softmasterge/hardware_a1/SS34B-HF/3D/SS34B-HF.stp

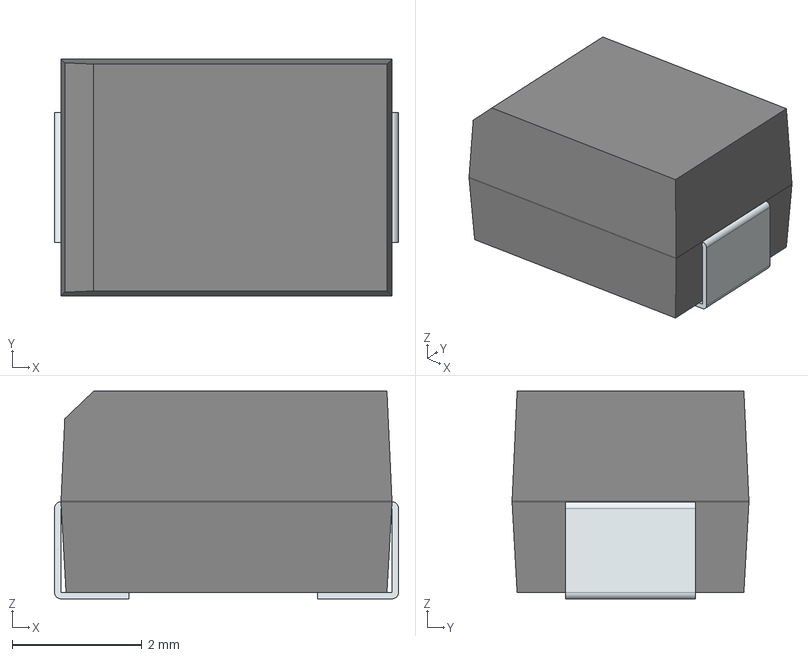
[picture p1: CAD file, 2021-02-08]
SS34B-HF/3D/SS34B-HF.stp
5.30 x 3.65 x 3.20 mm
FilletPin1
FilletPin2
