softmasterge/hardware_a1/supercap/XH414HG-IV01E.step

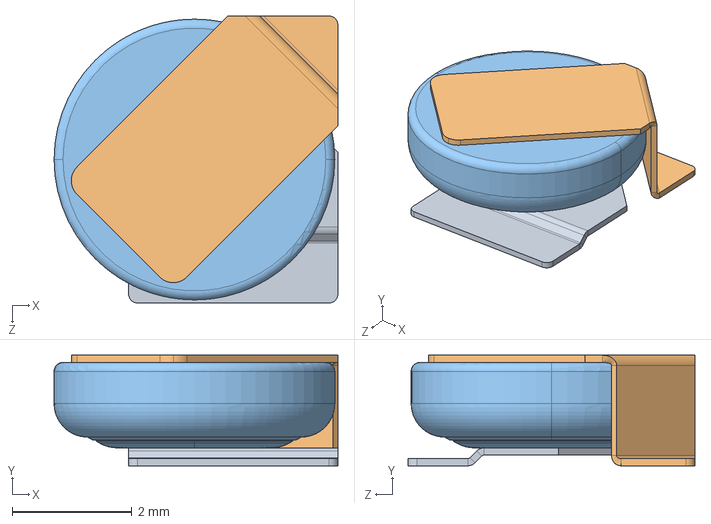
[picture p2: CAD file, 2021-02-16]
supercap/XH414HG-IV01E.step
4.75 x 1.85 x 4.80 mm
