softmasterge/hardware_a1/(list of files, cad)

Other CAD files:
SS34B-HF/3D/SS34B-HF.stl
SS34B-HF/Allegro/diom5336x320n.psm
SS34B-HF/DEHDL/ss34b_hf/chips/chips.prt
