softmasterge/hardware_a1/small/saxli.kicad_pcb

## KiCad design small/saxli.kicad_pcb (2021-03-10)

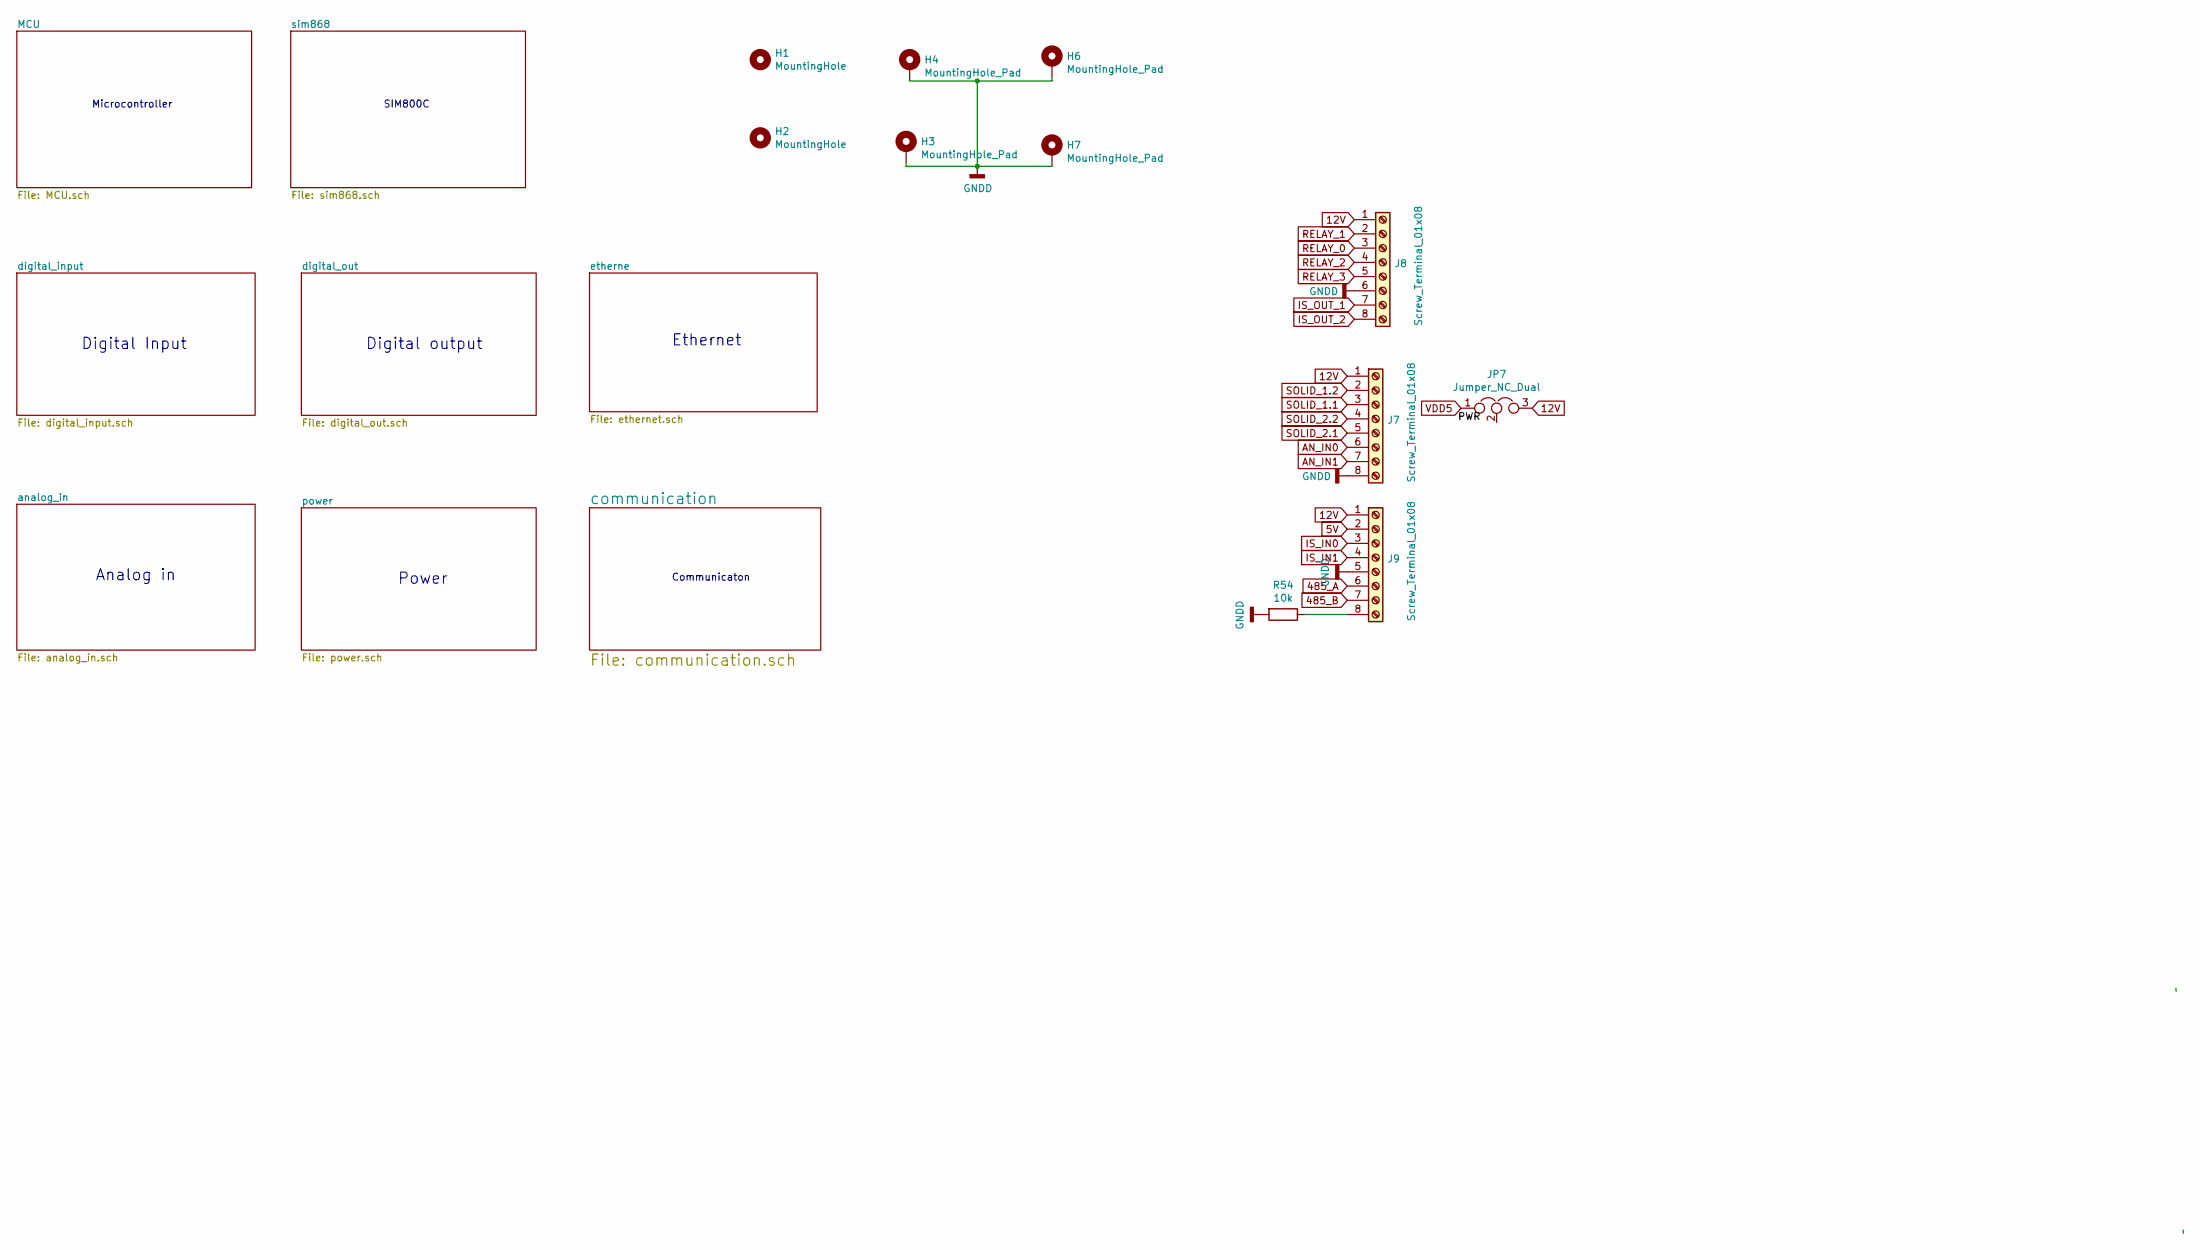
[picture p3: schematic saxli.sch]

Parts:
H1, H2: MountingHole; MountingHole_3.2mm_M3; LCSC N/A
H3, H4, H6, H7: MountingHole_Pad; MountingHole_3.2mm_M3_Pad; Mpn #; LCSC N/A
J7, J8, J9: Screw_Terminal_01x08; TerminalBlock_Phoenix_MPT-0,5-8-2.54_1x08_P2.54mm_Horizontal; LCSC N/A
JP7: Jumper_NC_Dual; SolderJumper-3_P1.3mm_Open_Pad1.0x1.5mm; LCSC N/A
R54: 10k; R_0603_1608Metric; MPN 0603WAF1002T5E; LCSC C25804

Connections:
5V: J9.2
12V: J7.1, J8.1, J9.1, JP7.3; also elsewhere on the board
485_A: J9.6; also elsewhere on the board
485_B: J9.7; also elsewhere on the board
AN_IN0: J7.6; also elsewhere on the board
AN_IN1: J7.7; also elsewhere on the board
GND: H3.1, H4.1, H6.1, H7.1, J7.8, J8.6, J9.5, R54.2; also elsewhere on the board
IS_IN0: J9.3; also elsewhere on the board
IS_IN1: J9.4; also elsewhere on the board
IS_OUT_1: J8.7; also elsewhere on the board
IS_OUT_2: J8.8; also elsewhere on the board
unnamed: J9.8, R54.1
RELAY_0: J8.3; also elsewhere on the board
RELAY_1: J8.2; also elsewhere on the board
RELAY_2: J8.4; also elsewhere on the board
RELAY_3: J8.5; also elsewhere on the board
SOLID_1.1: J7.3; also elsewhere on the board
SOLID_1.2: J7.2; also elsewhere on the board
SOLID_2.1: J7.5; also elsewhere on the board
SOLID_2.2: J7.4; also elsewhere on the board
VDD5: JP7.1; also elsewhere on the board

Notes on the sheet:
Microcontroller
Digital Input
Digital output
Ethernet
Analog in
Power
Communicaton
SIM800C

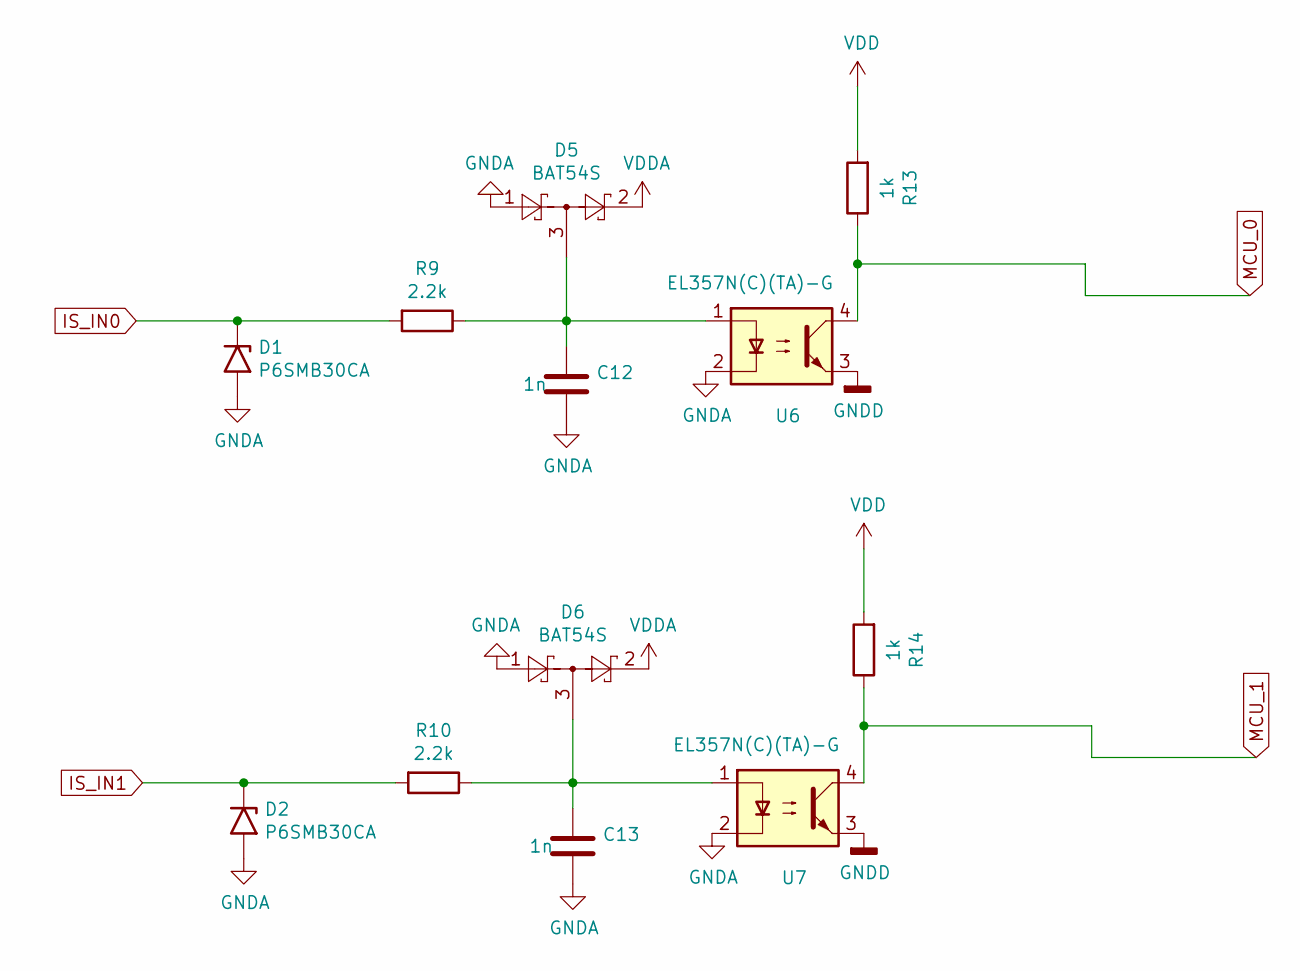
[picture p4: schematic digital_input.sch]

Parts:
C12, C13: 1n; C_0603_1608Metric; MPN CL21B102KBCNNNC; LCSC C46653
D1, D2: P6SMB30CA; D_SMB; MPN P6SMB30CA; LCSC C320521
D5, D6: BAT54S; SOT-23; MPN BAT54S L44; LCSC C122856
R9, R10: 2.2k; R_0805_2012Metric; MPN 0805W8F2201T5E; LCSC C17520
R13, R14: 1k; R_0805_2012Metric; MPN 0805W8F1001T5E; LCSC C17513
U6, U7: EL357N(C)(TA)-G; SO-4_4.4x3.6mm_P2.54mm; MPN EL357N(C)(TA)-G; LCSC C29981

Connections:
GND: C12.2, C13.2, D1.2 (A2), D2.2 (A2), D5.1, D6.1, U6.2, U6.3, U7.2, U7.3; also elsewhere on the board
IS_IN0: D1.1 (A1), R9.2; also elsewhere on the board
IS_IN1: D2.1 (A1), R10.2; also elsewhere on the board
MCU_0: R13.1, U6.4; also elsewhere on the board
MCU_1: R14.1, U7.4; also elsewhere on the board
unnamed: C12.1, D5.3, R9.1, U6.1
unnamed: C13.1, D6.3, R10.1, U7.1
VDD3: R13.2, R14.2; also elsewhere on the board
VDDA: D5.2, D6.2; also elsewhere on the board

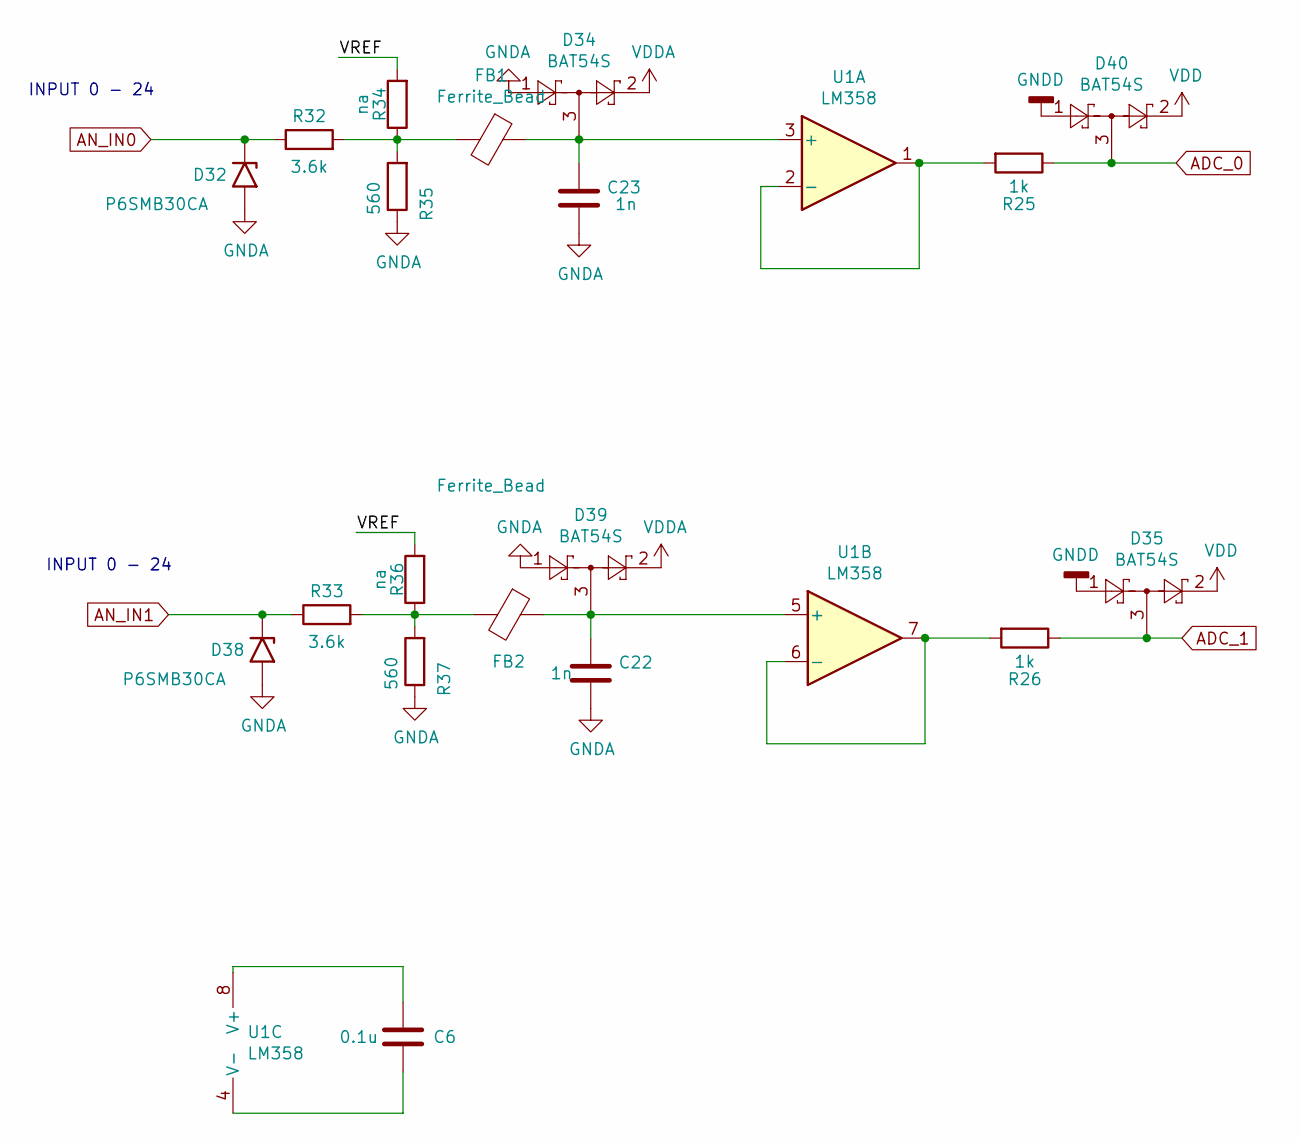
[picture p5: schematic analog_in.sch]

Parts:
C6: 0.1u; C_0603_1608Metric; MPN CC0603KRX7R9BB104; LCSC C14663
C22, C23: 1n; C_0603_1608Metric; MPN CL21B102KBCNNNC; LCSC C46653
D32, D38: P6SMB30CA; D_SMB; MPN P6SMB30CA; LCSC C320521
D34, D35, D39, D40: BAT54S; SOT-23; MPN BAT54S L44; LCSC C122856
FB1, FB2: Ferrite_Bead; R_0805_2012Metric_Pad1.20x1.40mm_HandSolder; MPN GZ2012D601TF; LCSC C1017
R25, R26: 1k; R_0603_1608Metric; MPN 0603WAF1001T5E; LCSC C21190
R32, R33: 3.6k; R_0805_2012Metric; MPN 0805W8F3601T5E; LCSC C18359
R34, R36: na; R_0603_1608Metric; LCSC N/A
R35, R37: 560; R_0805_2012Metric; MPN 0805W8F5600T5E; LCSC C28636
U1: LM358; SOIC-8_3.9x4.9mm_P1.27mm; LCSC C7950

Connections:
/analog_in/VREF: R34.2, R36.2
ADC_0: D40.3, R25.1; also elsewhere on the board
ADC_1: D35.3, R26.1; also elsewhere on the board
AN_IN0: D32.1 (A1), R32.1; also elsewhere on the board
AN_IN1: D38.1 (A1), R33.1; also elsewhere on the board
GND: C22.2, C23.2, D32.2 (A2), D34.1, D35.1, D38.2 (A2), D39.1, D40.1, R35.1, R37.1; also elsewhere on the board
unnamed: C6.1, U1.8 (V+)
unnamed: C6.2, U1.4 (V-)
unnamed: C22.1, D39.3, FB2.1, U1.5 (+)
unnamed: C23.1, D34.3, FB1.1, U1.3 (+)
unnamed: FB1.2, R32.2, R34.1, R35.2
unnamed: FB2.2, R33.2, R36.1, R37.2
unnamed: R25.2, U1.1, U1.2 (-)
unnamed: R26.2, U1.6 (-), U1.7
VDD3: D35.2, D40.2; also elsewhere on the board
VDDA: D34.2, D39.2; also elsewhere on the board

Notes on the sheet:
INPUT 0 - 24

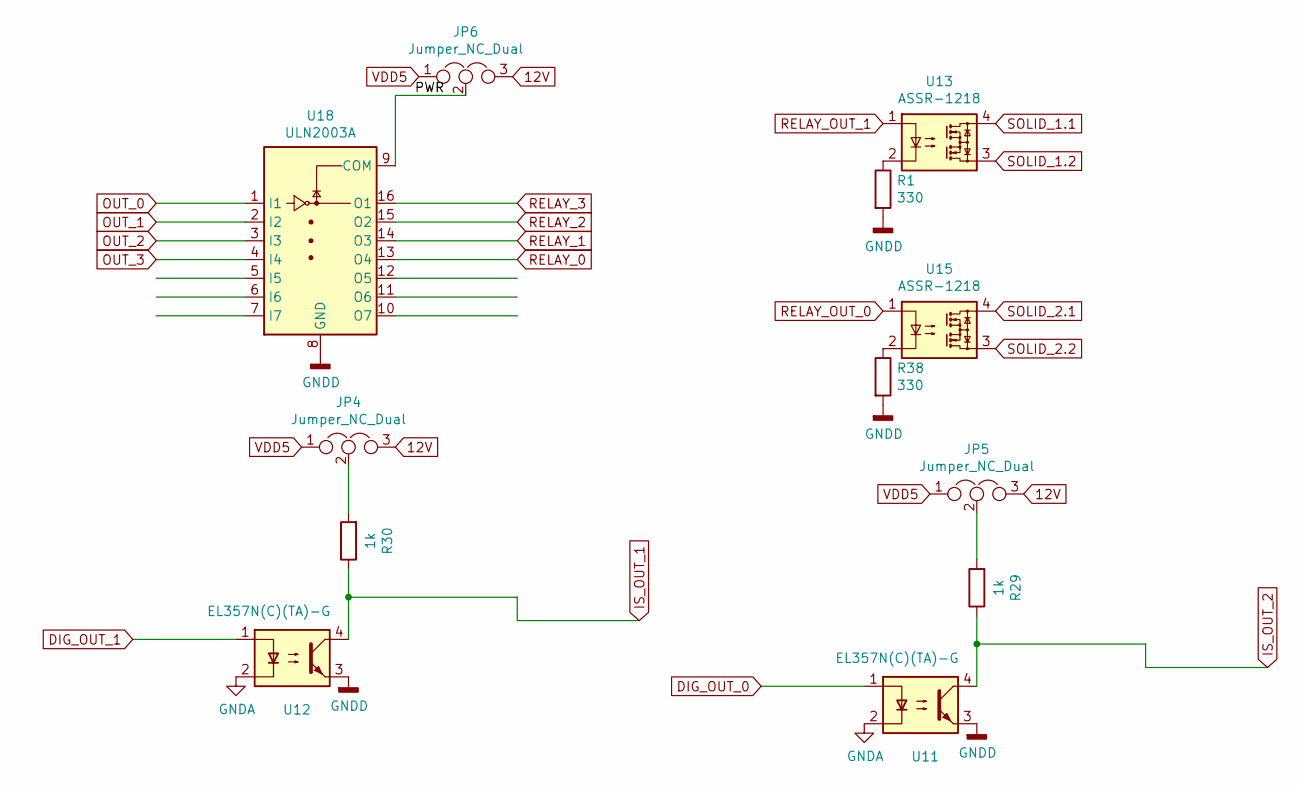
[picture p6: schematic digital_out.sch]

Parts:
JP4, JP5, JP6: Jumper_NC_Dual; SolderJumper-3_P1.3mm_Open_Pad1.0x1.5mm; LCSC N/A
R1, R38: 330; R_0603_1608Metric; MPN 0603WAF3300T5E; LCSC C23138
R29, R30: 1k; R_0805_2012Metric; MPN 0805W8F1001T5E; LCSC C17513
U11, U12: EL357N(C)(TA)-G; SO-4_4.4x3.6mm_P2.54mm; MPN EL357N(C)(TA)-G; LCSC C29981
U13, U15: ASSR-1218; SMDIP-4_W7.62mm; MPN AQY211EHAX; LCSC C129282
U18: ULN2003A; SOIC-16_3.9x9.9mm_P1.27mm; MPN ULN2003ADR; LCSC C7512

Connections:
12V: JP4.3, JP5.3, JP6.3; also elsewhere on the board
/digital_out/PWR: JP6.2, U18.9 (COM)
DIG_OUT_0: U11.1; also elsewhere on the board
DIG_OUT_1: U12.1; also elsewhere on the board
GND: R1.2, R38.2, U11.2, U11.3, U12.2, U12.3, U18.8 (GND); also elsewhere on the board
IS_OUT_1: R30.1, U12.4; also elsewhere on the board
IS_OUT_2: R29.1, U11.4; also elsewhere on the board
unnamed: JP4.2, R30.2
unnamed: JP5.2, R29.2
unnamed: R1.1, U13.2
unnamed: R38.1, U15.2
OUT_0: U18.1 (I1); also elsewhere on the board
OUT_1: U18.2 (I2); also elsewhere on the board
OUT_2: U18.3 (I3); also elsewhere on the board
OUT_3: U18.4 (I4); also elsewhere on the board
RELAY_0: U18.13 (O4); also elsewhere on the board
RELAY_1: U18.14 (O3); also elsewhere on the board
RELAY_2: U18.15 (O2); also elsewhere on the board
RELAY_3: U18.16 (O1); also elsewhere on the board
RELAY_OUT_0: U15.1; also elsewhere on the board
RELAY_OUT_1: U13.1; also elsewhere on the board
SOLID_1.1: U13.4; also elsewhere on the board
SOLID_1.2: U13.3; also elsewhere on the board
SOLID_2.1: U15.4; also elsewhere on the board
SOLID_2.2: U15.3; also elsewhere on the board
VDD5: JP4.1, JP5.1, JP6.1; also elsewhere on the board

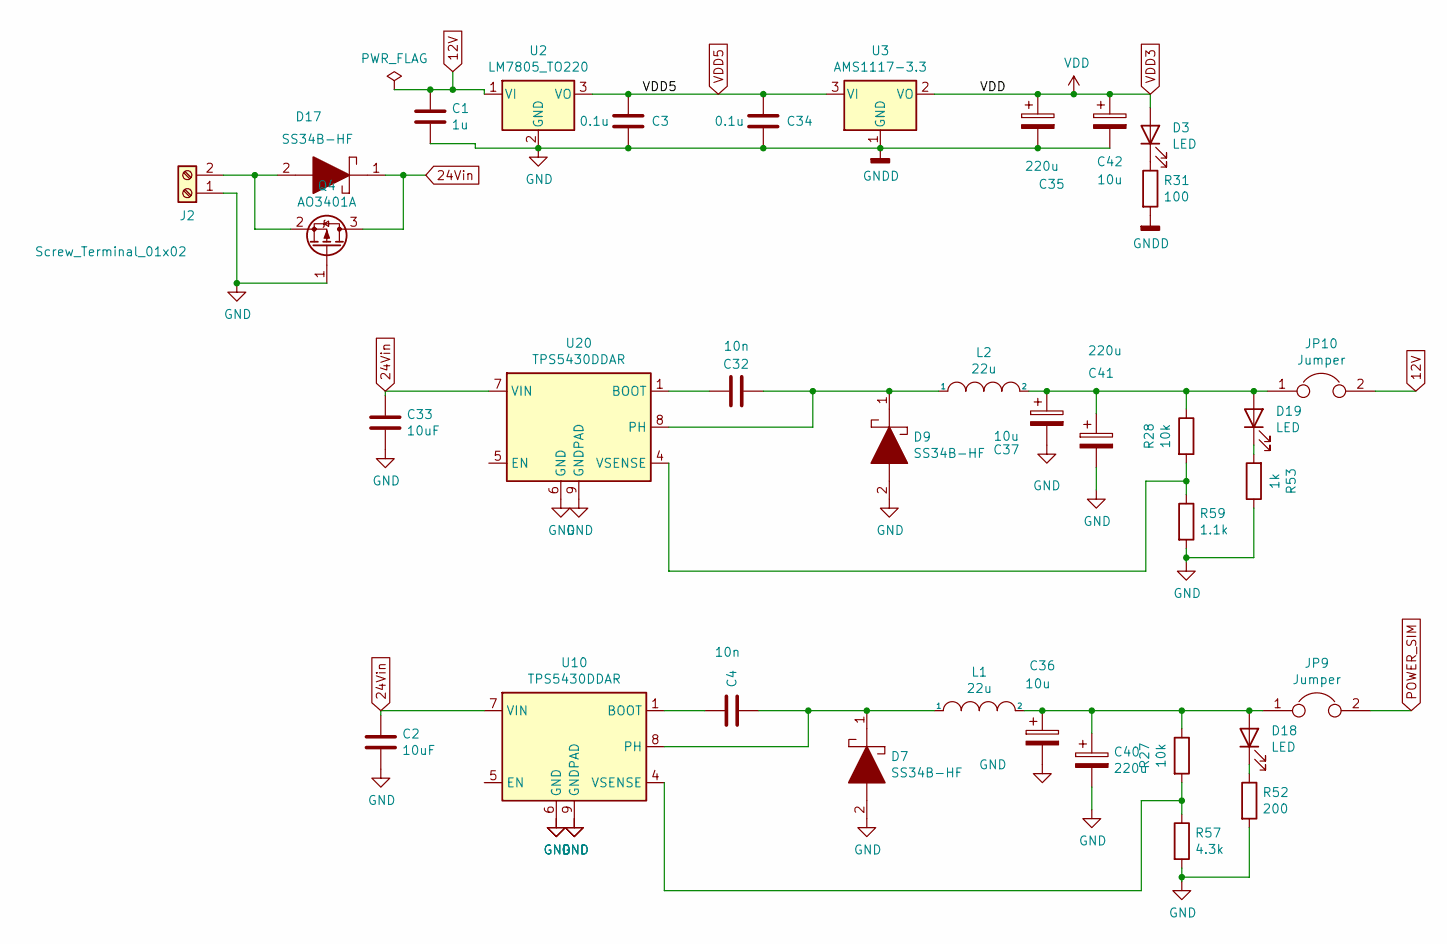
[picture p7: schematic power.sch]

Parts:
C1: 1u; R_0805_2012Metric; MPN CL21B105KBFNNNE; LCSC C28323
C2, C33: 10uF; C_1206_3216Metric; MPN CL31A106KBHNNNE; LCSC C13585
C3, C34: 0.1u; C_0603_1608Metric; MPN CC0603KRX7R9BB104; LCSC C14663
C4, C32: 10n; R_0603_1608Metric; MPN 0603B103K500NT; LCSC C57112
C35, C40, C41: 220u; CP_Elec_8x10; MPN VEH221M1VTR; LCSC C311611
C36, C37, C42: 10u; CP_EIA-3216-18_Kemet-A; MPN TAJA106K016RNJ; LCSC C7171
D3: LED; LED_0805_2012Metric; MPN FC-2012HRK-620D; LCSC C84256
D7, D9, D17: SS34B-HF; DIOM5336X320N; Mouser Part Number 750-SS34B-HF
D18, D19: LED; LED_0805_2012Metric_Pad1.15x1.40mm_HandSolder; MPN ORH-YG35A; LCSC C205449
J2: Screw_Terminal_01x02; TerminalBlock_Phoenix_MKDS-1,5-2-5.08_1x02_P5.08mm_Horizont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; Mpn Connector unknown; LCSC N/A
JP9, JP10: Jumper; SolderJumper-2_P1.3mm_Open_Pad1.0x1.5mm
L1, L2: 22u; L_10.4x10.4_H4.8; MPN SLO1040H220MTT; LCSC C182173
Q4: AO3401A; SOT-23; MPN AO3401A; LCSC C15127
R27, R28: 10k; R_0603_1608Metric; MPN 0603WAF1002T5E; LCSC C25804
R31: 100; R_0603_1608Metric; MPN 0603WAF1000T5E; LCSC C22775
R52: 200; R_0603_1608Metric; MPN 0603WAF2000T5E; LCSC C8218
R53: 1k; R_0805_2012Metric; MPN 0805W8F1001T5E; LCSC C17513
R57: 4.3k; R_0603_1608Metric; MPN 0603WAF4301T5E; LCSC C23159
R59: 1.1k; R_0603_1608Metric; MPN 0603WAF1101T5E; LCSC C22764
U2: LM7805_TO220; TO-252-2; MPN CJ7805; LCSC C21706
U3: AMS1117-3.3; SOT-223; MPN AMS1117-3.3; LCSC C6186
U10, U20: TPS5430DDAR; TI_SO-PowerPAD-8_ThermalVias; MPN TPS5430DDAR; LCSC C9864

Connections:
12V: C1.1, JP10.2, U2.1 (VI); also elsewhere on the board
24Vin: C2.1, C33.1, D17.1, Q4.3 (D), U10.7 (VIN), U20.7 (VIN)
GND: C1.2, C2.2, C3.2, C33.2, C34.2, C35.2, C36.2, C37.2, C40.2, C41.2, C42.2, D7.2, D9.2, J2.1, Q4.1 (G), R31.2, R52.2, R53.1, R57.2, R59.2, U2.2 (GND), U3.1 (GND), U10.6 (GND), U10.9 (GNDPAD), U20.6 (GND), U20.9 (GNDPAD); also elsewhere on the board
unnamed: C4.1, U10.1 (BOOT)
unnamed: C4.2, D7.1, L1.1, U10.8 (PH)
unnamed: C32.1, U20.1 (BOOT)
unnamed: C32.2, D9.1, L2.1, U20.8 (PH)
unnamed: C36.1, C40.1, D18.2 (A), JP9.1, L1.2, R27.1
unnamed: C37.1, C41.1, D19.2 (A), JP10.1, L2.2, R28.1
unnamed: D3.1 (K), R31.1
unnamed: D17.2, J2.2, Q4.2 (S)
unnamed: D18.1 (K), R52.1
unnamed: D19.1 (K), R53.2
unnamed: R27.2, R57.1, U10.4 (VSENSE)
unnamed: R28.2, R59.1, U20.4 (VSENSE)
POWER_SIM: JP9.2; also elsewhere on the board
VDD3: C35.1, C42.1, D3.2 (A), U3.2 (VO); also elsewhere on the board
VDD5: C3.1, C34.1, U2.3 (VO), U3.3 (VI); also elsewhere on the board

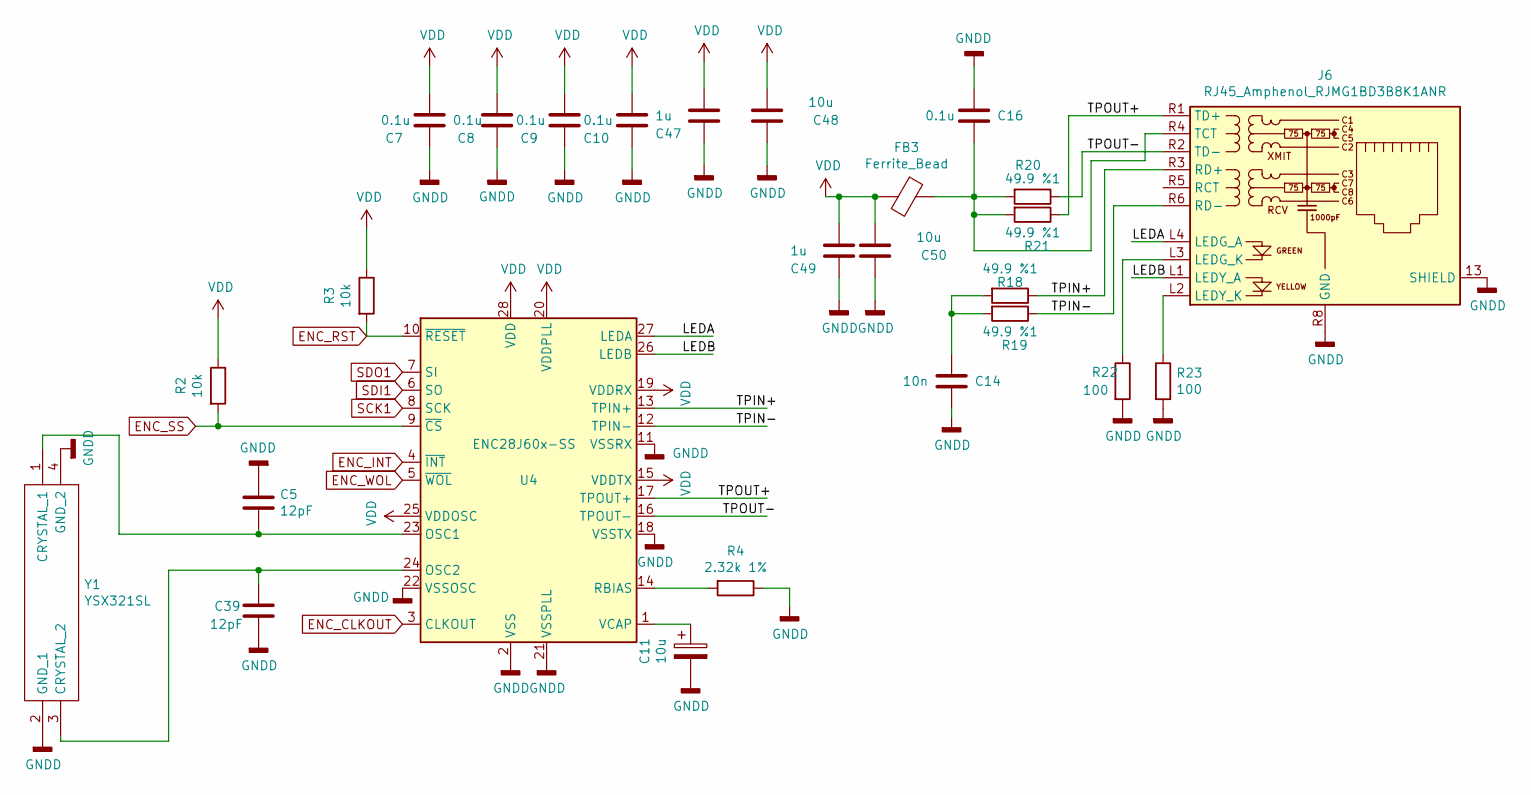
[picture p8: schematic ethernet.sch]

Parts:
C5, C39: 12pF; C_0603_1608Metric; MPN CL10C120JB8NNNC; LCSC C38523
C7, C8, C9, C10, C16: 0.1u; C_0603_1608Metric; MPN CC0603KRX7R9BB104; LCSC C14663
C11: 10u; CP_EIA-3216-18_Kemet-A; MPN TAJA106K016RNJ; LCSC C7171
C14: 10n; C_0603_1608Metric; MPN 0603B103K500NT; LCSC C57112
C47, C49: 1u; C_0603_1608Metric; MPN CL10A105KB8NNNC; LCSC C15849
C48, C50: 10u; C_0603_1608Metric; MPN GRM188R61E106KA73D; LCSC C344022
FB3: Ferrite_Bead; R_0805_2012Metric_Pad1.20x1.40mm_HandSolder; MPN GZ2012D601TF; LCSC C1017
J6: RJ45_Amphenol_RJMG1BD3B8K1ANR; LCSC N/A
R2, R3: 10k; R_0603_1608Metric; MPN 0603WAF1002T5E; LCSC C25804
R4: 2.32k 1%; R_0603_1608Metric; MPN 0603WAF2321T5E; LCSC C22905
R18, R19, R20, R21: 49.9 %1; R_0603_1608Metric; MPN 0603WAF499JT5E; LCSC C23185
R22, R23: 100; R_0603_1608Metric; MPN 0603WAF1005T5E; LCSC C7250
U4: ENC28J60x-SS; SOIC-28W_7.5x17.9mm_P1.27mm; LCSC C47351
Y1: YSX321SL; Manufacturer_Part_Number YSX321SL; LCSC C9006

Connections:
/etherne/LEDA: J6.L4 (LEDG_A), U4.27 (LEDA)
/etherne/LEDB: J6.L1 (LEDY_A), U4.26 (LEDB)
/etherne/TPIN+: J6.R3 (RD+), R18.1, U4.13 (TPIN+)
/etherne/TPIN-: J6.R6 (RD-), R19.1, U4.12 (TPIN-)
/etherne/TPOUT+: J6.R1 (TD+), R21.1, U4.17 (TPOUT+)
/etherne/TPOUT-: J6.R2 (TD-), R20.1, U4.16 (TPOUT-)
ENC_CLKOUT: U4.3 (CLKOUT)
ENC_INT: U4.4 (~INT); also elsewhere on the board
ENC_RST: R3.2, U4.10 (~RESET); also elsewhere on the board
ENC_SS: R2.2, U4.9 (~CS); also elsewhere on the board
ENC_WOL: U4.5 (~WOL); also elsewhere on the board
GND: C5.1, C7.2, C8.2, C9.2, C10.2, C11.2, C14.2, C16.1, C39.2, C47.2, C48.2, C49.2, C50.2, J6.13 (SHIELD), J6.R8 (GND), R4.1, R22.2, R23.2, U4.2 (VSS), U4.11 (VSSRX), U4.18 (VSSTX), U4.21 (VSSPLL), U4.22 (VSSOSC), Y1.2 (GND_1), Y1.4 (GND_2); also elsewhere on the board
unnamed: C5.2, U4.23 (OSC1), Y1.1 (CRYSTAL_1)
unnamed: C11.1, U4.1 (VCAP)
unnamed: C14.1, R18.2, R19.2
unnamed: C16.2, FB3.1, J6.R4 (TCT), R20.2, R21.2
unnamed: C39.1, U4.24 (OSC2), Y1.3 (CRYSTAL_2)
unnamed: J6.L2 (LEDY_K), R23.1
unnamed: J6.L3 (LEDG_K), R22.1
unnamed: R4.2, U4.14 (RBIAS)
SCK1: U4.8 (SCK); also elsewhere on the board
SDI1: U4.6 (SO); also elsewhere on the board
SDO1: U4.7 (SI); also elsewhere on the board
VDD3: C7.1, C8.1, C9.1, C10.1, C47.1, C48.1, C49.1, C50.1, FB3.2, R2.1, R3.1, U4.15 (VDDTX), U4.19 (VDDRX), U4.20 (VDDPLL), U4.25 (VDDOSC), U4.28 (VDD); also elsewhere on the board

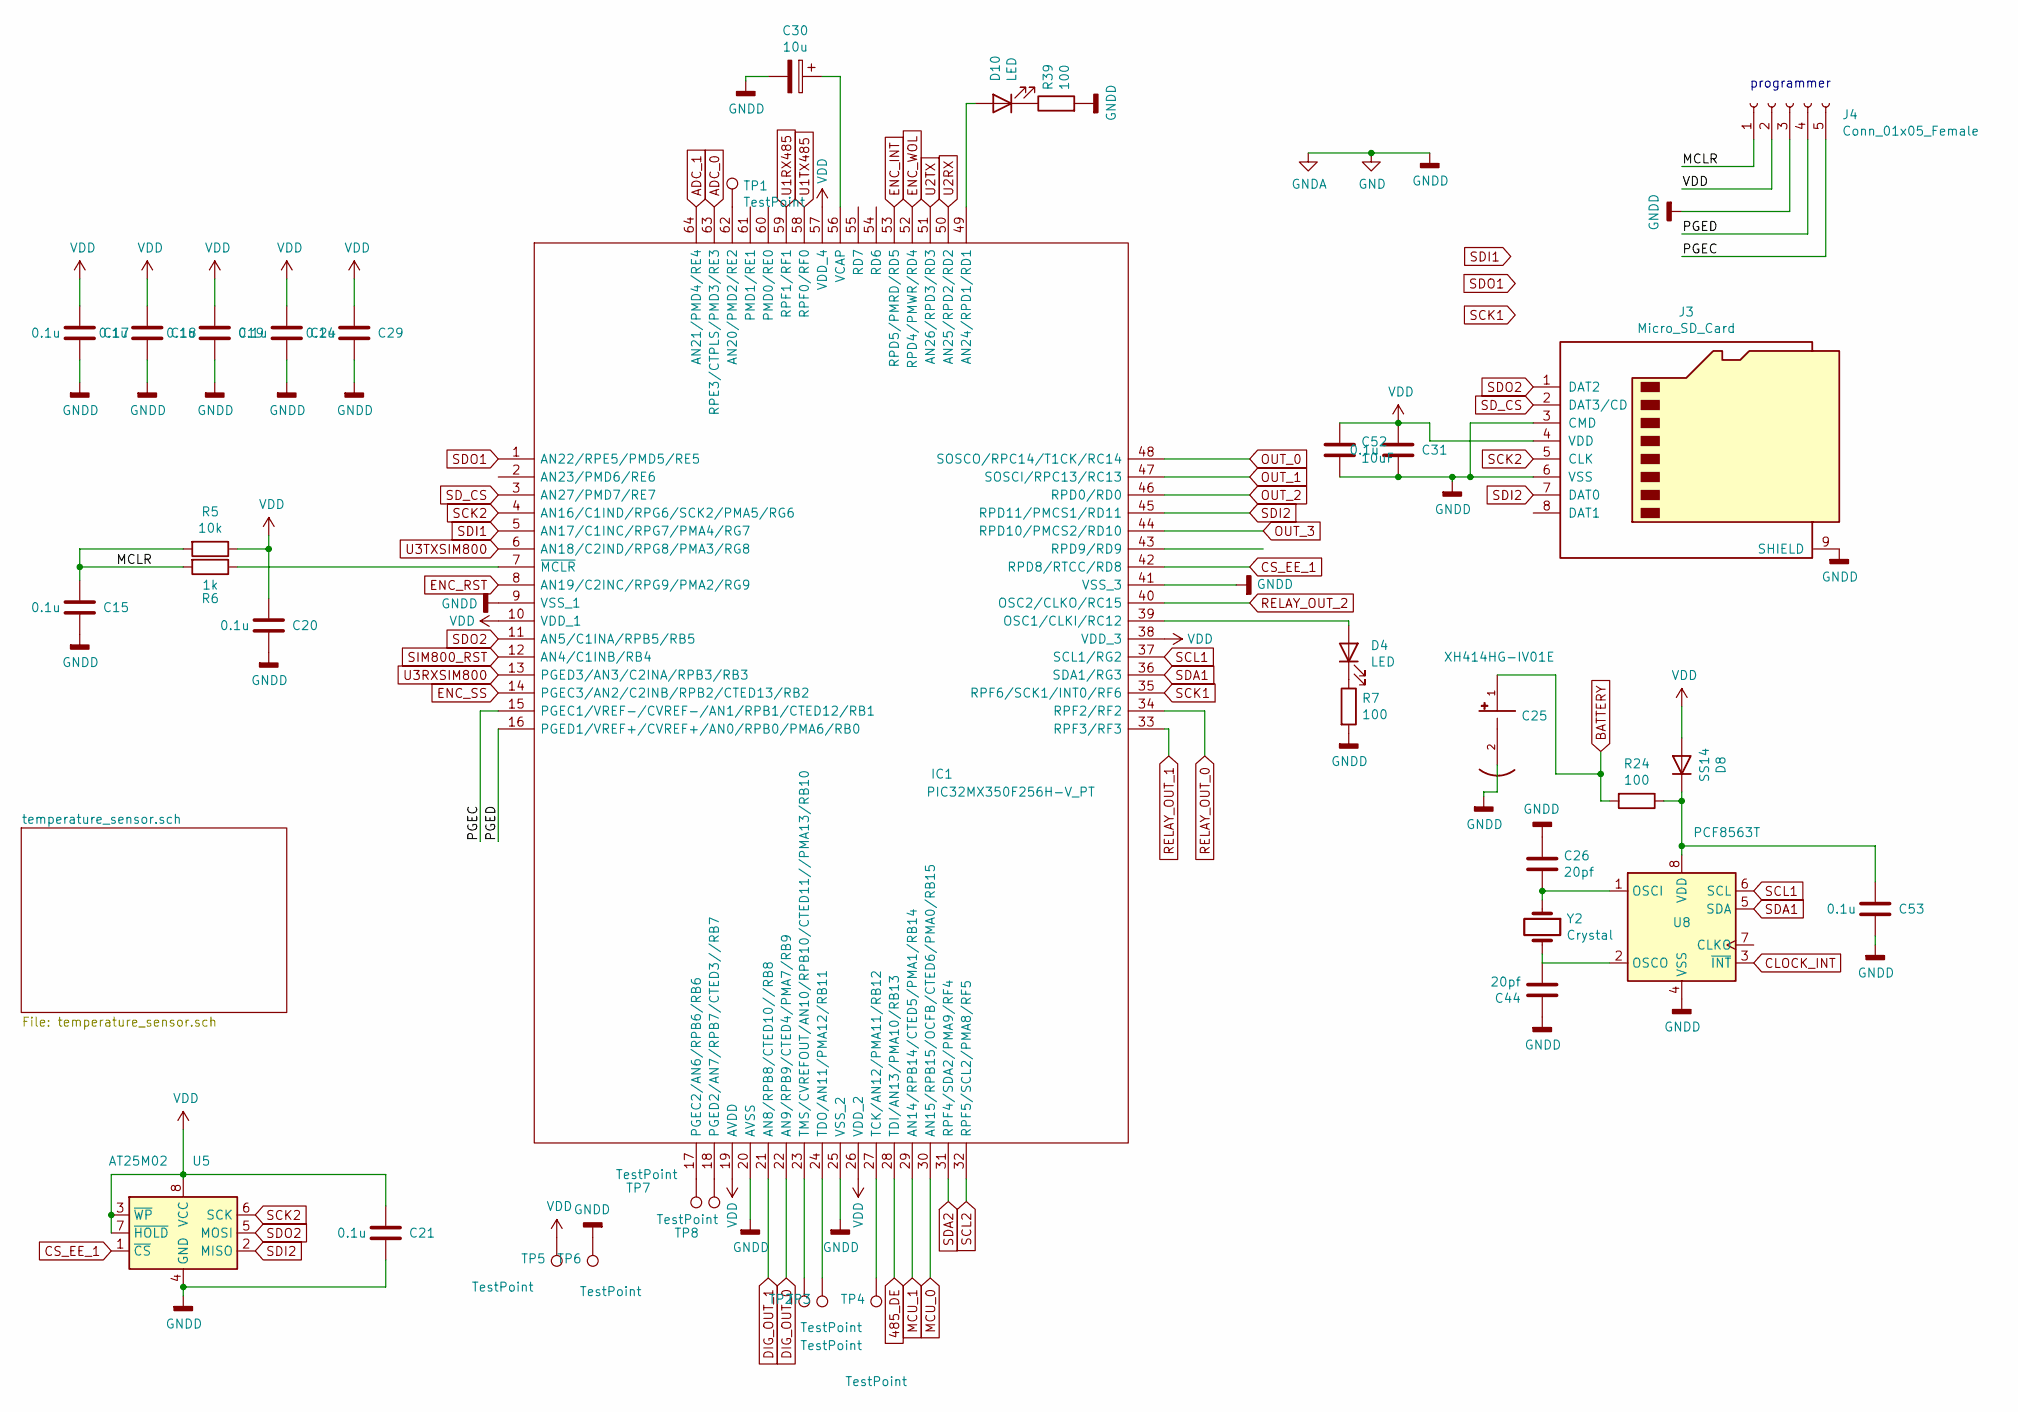
[picture p9: schematic MCU.sch]

Parts:
C15, C17, C18, C19, C20, C21, C24, C29, C31, C53: 0.1u; C_0603_1608Metric; MPN CC0603KRX7R9BB104; LCSC C14663
C25: XH414HG-IV01E; CAP_XH414HG-IV01E; MPN XH414HG-IV01E; LCSC C38065
C26, C44: 20pf; C_0603_1608Metric_Pad1.08x0.95mm_HandSolder; MPN CL10C200JB8NNNC; LCSC C1648
C30: 10u; CP_EIA-3216-18_Kemet-A; MPN TAJA106K016RNJ; LCSC C7171
C52: 10uF; C_1206_3216Metric; MPN CL31A106KBHNNNE; LCSC C13585
D4, D10: LED; LED_0805_2012Metric; MPN FC-2012HRK-620D; LCSC C84256
D8: SS14; D_SMA; MPN SS14; LCSC C2480
IC1: PIC32MX350F256H-V_PT; QFP50P1200X1200X120-64N; Mouser Part Number 579-32MX350F256HVPT
J3: Micro_SD_Card; microSD_HC_Hirose_DM3BT-DSF-PEJS; LCSC N/A
J4: Conn_01x05_Female; PinHeader_1x05_P2.54mm_Vertical; Mpn Connector unknown; LCSC N/A
R5: 10k; R_0603_1608Metric; MPN 0603WAF1002T5E; LCSC C25804
R6: 1k; R_0603_1608Metric; MPN 0603WAF1001T5E; LCSC C21190
R7, R39: 100; R_0603_1608Metric; MPN 0603WAF1000T5E; LCSC C22775
R24: 100; R_0603_1608Metric; MPN 0603WAF1005T5E; LCSC C7250
TP1, TP2, TP3, TP4, TP5, TP6, TP7, TP8: TestPoint; TestPoint_Pad_1.5x1.5mm; LCSC N/A
U5: AT25M02; SOIC-8_3.9x4.9mm_P1.27mm; MPN AT25M02-SSHD-T; LCSC N/A
U8: PCF8563T; SOIC-8_3.9x4.9mm_P1.27mm; MPN PCF8563T; LCSC C7440
Y2: Crystal; Crystal_SMD_3215-2Pin_3.2x1.5mm; MPN Q13FC1350000400; LCSC C32346

Connections:
485_DE: IC1.28 (TDI/AN13/PMA10/RB13); also elsewhere on the board
/MCU/MCLR: C15.1, J4.1, R5.2, R6.2
/MCU/PGEC: IC1.15 (PGEC1/VREF-/CVREF-/AN1/RPB1/CTED12/RB1), J4.5
/MCU/PGED: IC1.16 (PGED1/VREF+/CVREF+/AN0/RPB0/PMA6/RB0), J4.4
ADC_0: IC1.63 (RPE3/CTPLS/PMD3/RE3); also elsewhere on the board
ADC_1: IC1.64 (AN21/PMD4/RE4); also elsewhere on the board
BATTERY: C25.1, R24.2
CLOCK_INT: U8.3 (~INT~)
CS_EE_1: IC1.42 (RPD8/RTCC/RD8), U5.1 (~CS)
DIG_OUT_0: IC1.22 (AN9/RPB9/CTED4/PMA7/RB9); also elsewhere on the board
DIG_OUT_1: IC1.21 (AN8/RPB8/CTED10//RB8); also elsewhere on the board
ENC_INT: IC1.53 (RPD5/PMRD/RD5); also elsewhere on the board
ENC_RST: IC1.8 (AN19/C2INC/RPG9/PMA2/RG9); also elsewhere on the board
ENC_SS: IC1.14 (PGEC3/AN2/C2INB/RPB2/CTED13/RB2); also elsewhere on the board
ENC_WOL: IC1.52 (RPD4/PMWR/RD4); also elsewhere on the board
GND: C15.2, C17.2, C18.2, C19.2, C20.2, C21.2, C24.2, C25.2, C26.1, C29.2, C30.2, C31.2, C44.1, C52.2, C53.2, IC1.9 (VSS_1), IC1.20 (AVSS), IC1.25 (VSS_2), IC1.41 (VSS_3), J3.3 (CMD), J3.6 (VSS), J3.9 (SHIELD), J4.3, R7.2, R39.2, TP6.1, U5.4 (GND), U8.4 (VSS); also elsewhere on the board
MCU_0: IC1.30 (AN15/RPB15/OCFB/CTED6/PMA0/RB15); also elsewhere on the board
MCU_1: IC1.29 (AN14/RPB14/CTED5/PMA1/RB14); also elsewhere on the board
unnamed: C26.2, U8.1 (OSCI), Y2.1
unnamed: C30.1, IC1.56 (VCAP)
unnamed: C44.2, U8.2 (OSCO), Y2.2
unnamed: C53.1, D8.2 (K), R24.1, U8.8 (VDD)
unnamed: D4.1 (K), R7.1
unnamed: D4.2 (A), IC1.39 (OSC1/CLKI/RC12)
unnamed: D10.1 (K), R39.1
unnamed: D10.2 (A), IC1.49 (AN24/RPD1/RD1)
unnamed: IC1.7 (~MCLR), R6.1
unnamed: IC1.17 (PGEC2/AN6/RPB6/RB6), TP7.1
unnamed: IC1.18 (PGED2/AN7/RPB7/CTED3//RB7), TP8.1
unnamed: IC1.23 (TMS/CVREFOUT/AN10/RPB10/CTED11//PMA13/R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), TP2.1
unnamed: IC1.24 (TDO/AN11/PMA12/RB11), TP3.1
unnamed: IC1.27 (TCK/AN12/PMA11/RB12), TP4.1
unnamed: IC1.62 (AN20/PMD2/RE2), TP1.1
OUT_0: IC1.48 (SOSCO/RPC14/T1CK/RC14); also elsewhere on the board
OUT_1: IC1.47 (SOSCI/RPC13/RC13); also elsewhere on the board
OUT_2: IC1.46 (RPD0/RD0); also elsewhere on the board
OUT_3: IC1.44 (RPD10/PMCS2/RD10); also elsewhere on the board
RELAY_OUT_0: IC1.34 (RPF2/RF2); also elsewhere on the board
RELAY_OUT_1: IC1.33 (RPF3/RF3); also elsewhere on the board
RELAY_OUT_2: IC1.40 (OSC2/CLKO/RC15)
SCK1: IC1.35 (RPF6/SCK1/INT0/RF6); also elsewhere on the board
SCK2: IC1.4 (AN16/C1IND/RPG6/SCK2/PMA5/RG6), J3.5 (CLK), U5.6 (SCK)
SCL1: IC1.37 (SCL1/RG2), U8.6 (SCL); also elsewhere on the board
SCL2: IC1.32 (RPF5/SCL2/PMA8/RF5); also elsewhere on the board
SDA1: IC1.36 (SDA1/RG3), U8.5 (SDA); also elsewhere on the board
SDA2: IC1.31 (RPF4/SDA2/PMA9/RF4); also elsewhere on the board
SDI1: IC1.5 (AN17/C1INC/RPG7/PMA4/RG7); also elsewhere on the board
SDI2: IC1.45 (RPD11/PMCS1/RD11), J3.7 (DAT0), U5.2 (MISO)
SDO1: IC1.1 (AN22/RPE5/PMD5/RE5); also elsewhere on the board
SDO2: IC1.11 (AN5/C1INA/RPB5/RB5), J3.1 (DAT2), U5.5 (MOSI)
SD_CS: IC1.3 (AN27/PMD7/RE7), J3.2 (DAT3/CD)
SIM800_RST: IC1.12 (AN4/C1INB/RB4); also elsewhere on the board
U1RX485: IC1.59 (RPF1/RF1); also elsewhere on the board
U1TX485: IC1.58 (RPF0/RF0); also elsewhere on the board
U2RX: IC1.50 (AN25/RPD2/RD2); also elsewhere on the board
U2TX: IC1.51 (AN26/RPD3/RD3); also elsewhere on the board
U3RXSIM800: IC1.13 (PGED3/AN3/C2INA/RPB3/RB3); also elsewhere on the board
U3TXSIM800: IC1.6 (AN18/C2IND/RPG8/PMA3/RG8); also elsewhere on the board
VDD3: C17.1, C18.1, C19.1, C20.1, C21.1, C24.1, C29.1, C31.1, C52.1, D8.1 (A), IC1.10 (VDD_1), IC1.19 (AVDD), IC1.26 (VDD_2), IC1.38 (VDD_3), IC1.57 (VDD_4), J3.4 (VDD), J4.2, R5.1, TP5.1, U5.3 (~WP), U5.7 (~HOLD), U5.8 (VCC); also elsewhere on the board

Notes on the sheet:
programmer
