softmasterge/hardware_a1/small/saxli.kicad_pcb

## KiCad design small/saxli.kicad_pcb (continued)

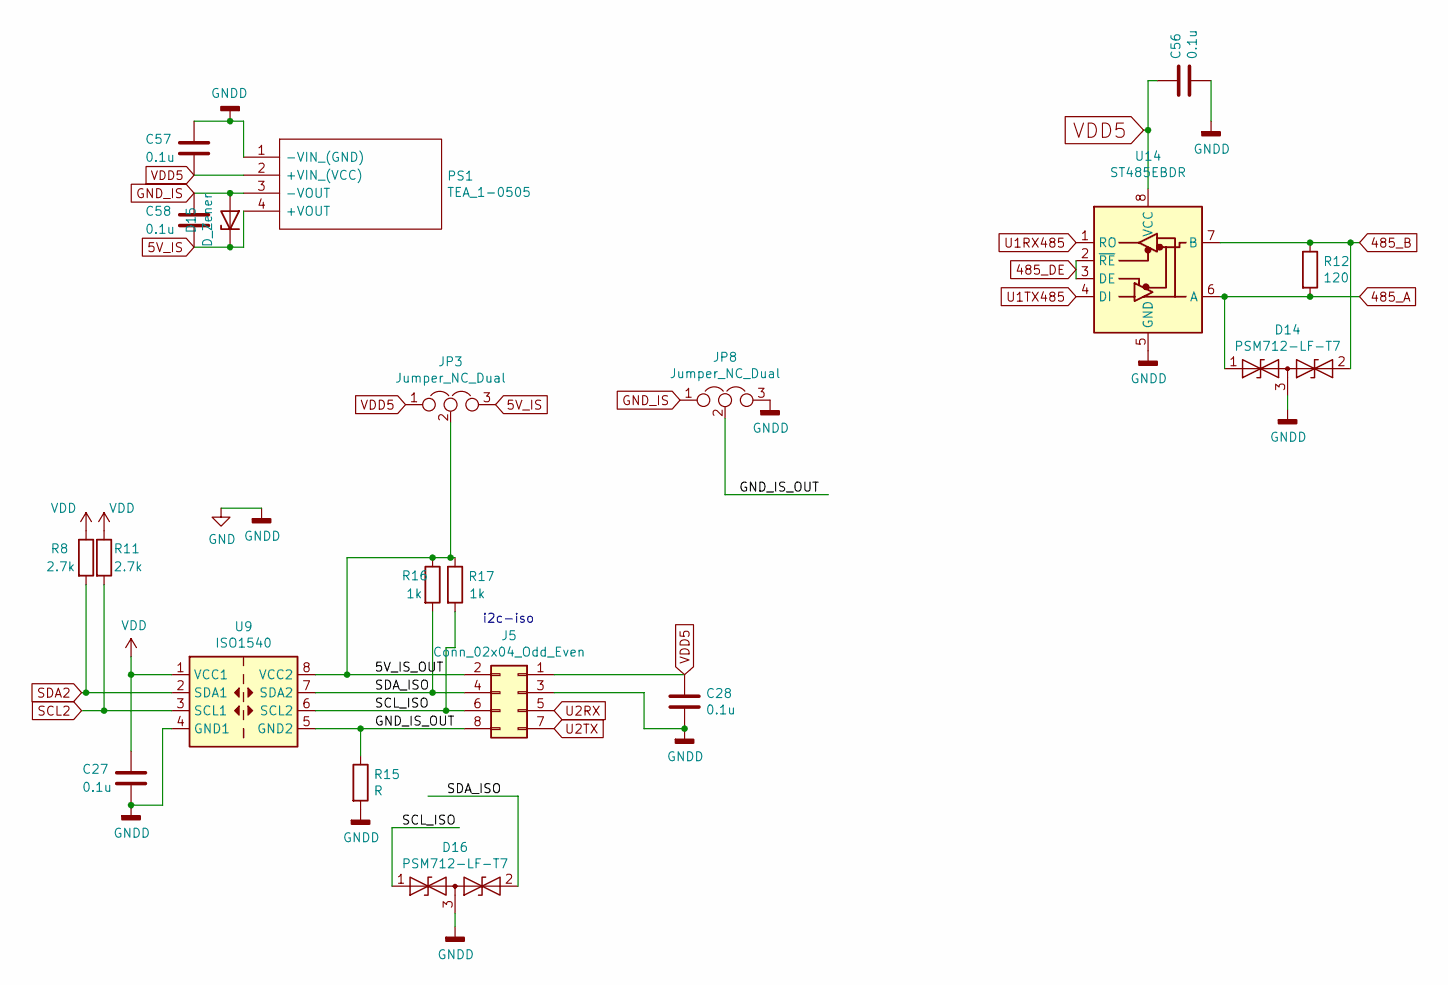
[picture p10: schematic communication.sch]

Parts:
C27, C28, C56, C57, C58: 0.1u; C_0603_1608Metric; Mpn 885012207098; LCSC C14663
D14, D16: PSM712-LF-T7; SOT-23; MPN PSM712-LF-T7; LCSC C32677
D15: D_Zener; D_MiniMELF; MPN ZMM5V6; LCSC C8062
J5: Conn_02x04_Odd_Even; PinHeader_2x04_P2.54mm_Vertical; Mpn Connector unknown; LCSC N/A
JP3, JP8: Jumper_NC_Dual; SolderJumper-3_P1.3mm_Open_Pad1.0x1.5mm; LCSC N/A
PS1: TEA_1-0505; TEA10505; Manufacturer_Part_Number TEA 1-0505; Mouser Part Number 495-TEA1-0505
R8, R11: 2.7k; R_0603_1608Metric; MPN 0603WAF2701T5E; LCSC C13167
R12: 120; R_0805_2012Metric; MPN 0805W8F1200T5E; LCSC C17437
R15: R; R_0805_2012Metric; MPN 0805W8F1001T5E; LCSC C17513
R16: 1k; R_0805_2012Metric; Mpn 0805W8F1001T5E; LCSC C17513
R17: 1k; R_0805_2012Metric; Mpn CRCW08051K00FKEAC; LCSC C17513
U9: ISO1540; SOIC-8_3.9x4.9mm_P1.27mm; MPN ISO1540DR; LCSC C179739
U14: ST485EBDR; SOIC-8_3.9x4.9mm_P1.27mm; MPN ST485EBDR; LCSC C81186

Connections:
5V_IS: C58.2, D15.1 (K), JP3.3, PS1.4 (+VOUT)
485_A: D14.1 (A1), R12.2, U14.6 (A); also elsewhere on the board
485_B: D14.2 (A2), R12.1, U14.7 (B); also elsewhere on the board
485_DE: U14.2 (~RE), U14.3 (DE); also elsewhere on the board
/communication/5V_IS_OUT: J5.2, JP3.2, R16.1, R17.1, U9.8 (VCC2)
/communication/GND_IS_OUT: J5.8, JP8.2, R15.1, U9.5 (GND2)
/communication/SCL_ISO: D16.1 (A1), J5.6, R17.2, U9.6 (SCL2)
/communication/SDA_ISO: D16.2 (A2), J5.4, R16.2, U9.7 (SDA2)
GND: C27.2, C28.2, C56.2, C57.1, D14.3 (common), D16.3 (common), J5.3, JP8.3, PS1.1 (-VIN_(GND)), R15.2, U9.4 (GND1), U14.5 (GND); also elsewhere on the board
GND_IS: C58.1, D15.2 (A), JP8.1, PS1.3 (-VOUT)
SCL2: R11.2, U9.3 (SCL1); also elsewhere on the board
SDA2: R8.2, U9.2 (SDA1); also elsewhere on the board
U1RX485: U14.1 (RO); also elsewhere on the board
U1TX485: U14.4 (DI); also elsewhere on the board
U2RX: J5.5; also elsewhere on the board
U2TX: J5.7; also elsewhere on the board
VDD3: C27.1, R8.1, R11.1, U9.1 (VCC1); also elsewhere on the board
VDD5: C28.1, C56.1, C57.2, J5.1, JP3.1, PS1.2 (+VIN_(VCC)), U14.8 (VCC); also elsewhere on the board

Notes on the sheet:
i2c-iso

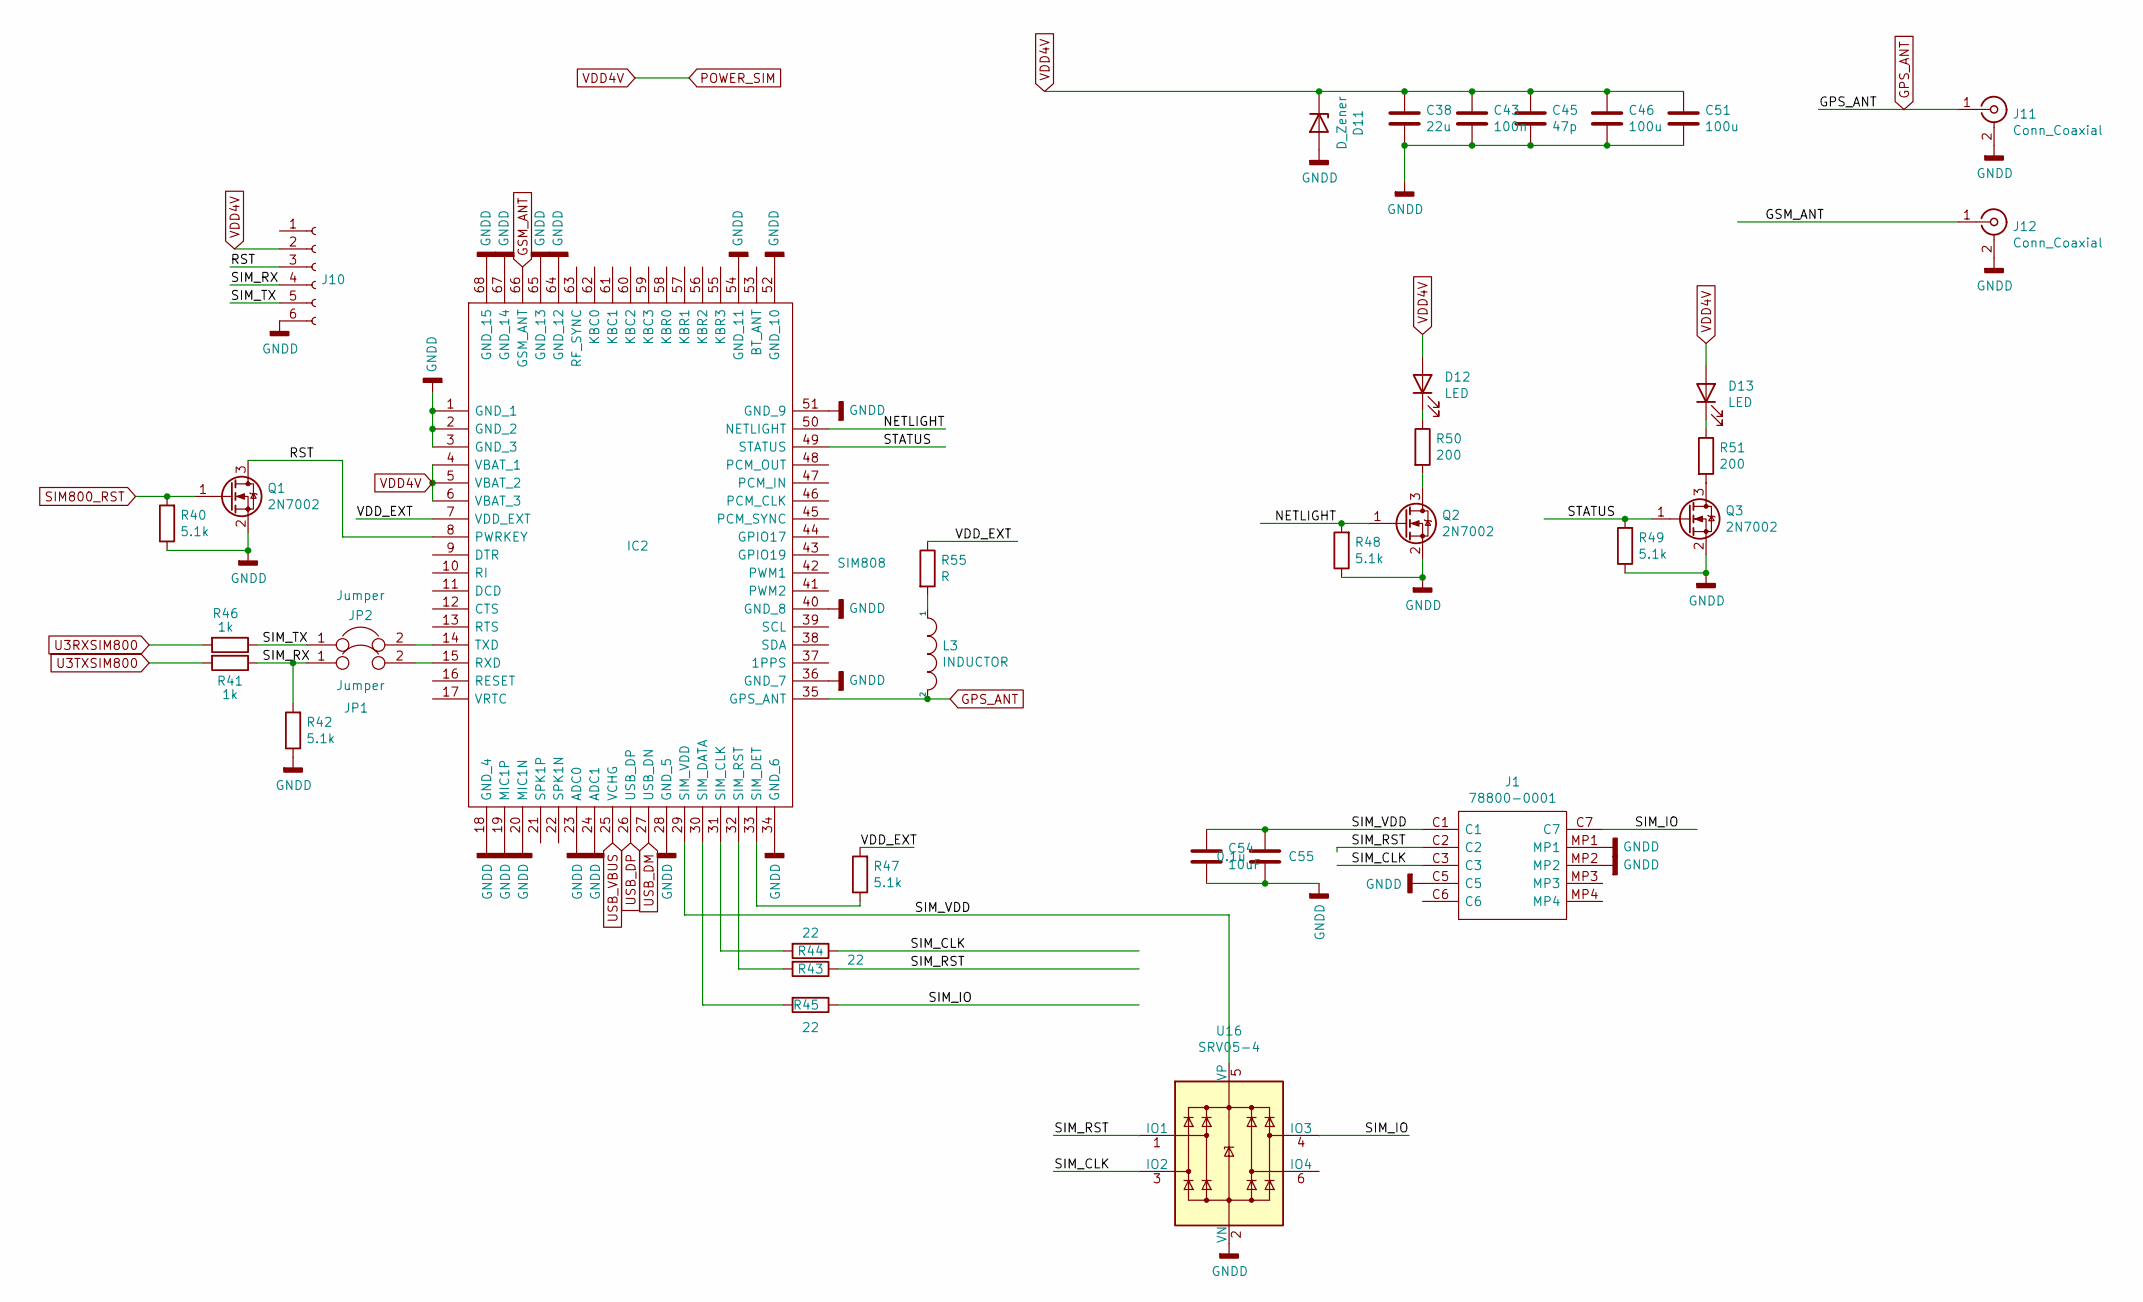
[picture p11: schematic sim868.sch]

Parts:
C38: 22u; R_0805_2012Metric; MPN CL21A226MAQNNNE; LCSC C45783
C43: 100n; C_0603_1608Metric; MPN CC0603KRX7R9BB104; LCSC C14663
C45: 47p; C_0603_1608Metric; MPN CL10C470JB8NNNC; LCSC C1671
C46, C51: 100u; CP_EIA-3528-21_Kemet-B; MPN TAJB107K006RNJ; LCSC C16133
C54: 10uF; C_1206_3216Metric; MPN CL31A106KBHNNNE; LCSC C13585
C55: 0.1u; C_0603_1608Metric; MPN CC0603KRX7R9BB104; LCSC C14663
D11: D_Zener; D_MiniMELF; MPN ZMM5V6; LCSC C8062
D12: LED; LED_0805_2012Metric_Pad1.15x1.40mm_HandSolder; MPN 17-21SUYC/TR8; LCSC C2296
D13: LED; LED_0805_2012Metric_Pad1.15x1.40mm_HandSolder; MPN FC-2012HRK-620D; LCSC C84256
IC2: SIM808; MPN SIM808; LCSC N/A
J1: 78800-0001; 788000001; Mouser Part Number 538-78800-0001
J10: Conn_01x06_Female; PinHeader_1x06_P2.54mm_Vertical; LCSC N/A
J11, J12: Conn_Coaxial; SMA_Amphenol_901-144_Vertical; MPN 73391-0070; LCSC N/A
JP1, JP2: Jumper; SolderJumper-2_P1.3mm_Open_RoundedPad1.0x1.5mm; LCSC N/A
L3: INDUCTOR; L_0603_1608Metric; MPN SDCL1608C27NJTDF; LCSC C12100
Q1, Q2, Q3: 2N7002; SOT-23; MPN 2N7002; LCSC C8545
R40, R42, R47, R48, R49: 5.1k; R_0603_1608Metric; MPN 0603WAF5101T5E; LCSC C23186
R41, R46: 1k; R_0603_1608Metric; MPN 0603WAF1001T5E; LCSC C21190
R43, R44, R45: 22; R_0603_1608Metric; MPN 0603WAF220JT5E; LCSC C23345
R50, R51: 200; R_0603_1608Metric; MPN 0603WAF2000T5E; LCSC C8218
R55: R; R_0603_1608Metric; MPN 0603WAF5100T5E; LCSC C23193
U16: SRV05-4; SOT-23-6; MPN SRV05-4-P-T7; LCSC C85364

Connections:
/sim868/NETLIGHT: IC2.50 (NETLIGHT), Q2.1 (G), R48.2
/sim868/RST: IC2.8 (PWRKEY), J10.3, Q1.3 (D)
/sim868/SIM_CLK: J1.C3, R44.1, U16.3 (IO2)
/sim868/SIM_IO: J1.C7, R45.1, U16.4 (IO3)
/sim868/SIM_RST: J1.C2, R43.1, U16.1 (IO1)
/sim868/SIM_RX: J10.4, JP2.1, R41.1, R42.2
/sim868/SIM_TX: J10.5, JP1.1, R46.1
/sim868/SIM_VDD: C54.1, C55.1, IC2.29 (SIM_VDD), J1.C1, U16.5 (VP)
/sim868/STATUS: IC2.49 (STATUS), Q3.1 (G), R49.2
/sim868/VDD_EXT: IC2.7 (VDD_EXT), R47.2, R55.1
GND: C38.2, C43.2, C45.2, C46.2, C51.2, C54.2, C55.2, D11.2 (A), IC2.1 (GND_1), IC2.2 (GND_2), IC2.3 (GND_3), IC2.18 (GND_4), IC2.19 (MIC1P), IC2.20 (MIC1N), IC2.23 (ADC0), IC2.24 (ADC1), IC2.28 (GND_5), IC2.34 (GND_6), IC2.36 (GND_7), IC2.40 (GND_8), IC2.51 (GND_9), IC2.52 (GND_10), IC2.54 (GND_11), IC2.64 (GND_12), IC2.65 (GND_13), IC2.67 (GND_14), IC2.68 (GND_15), J1.C5, J1.MP1, J1.MP2, J10.6, J11.2 (Ext), J12.2 (Ext), Q1.2 (S), Q2.2 (S), Q3.2 (S), R40.1, R42.1, R48.1, R49.1, U16.2 (VN); also elsewhere on the board
GPS_ANT: IC2.35 (GPS_ANT), J11.1 (In), L3.2
GSM_ANT: IC2.66 (GSM_ANT), J12.1 (In)
unnamed: D12.1 (K), R50.1
unnamed: D13.1 (K), R51.1
unnamed: IC2.14 (TXD), JP1.2
unnamed: IC2.15 (RXD), JP2.2
unnamed: IC2.30 (SIM_DATA), R45.2
unnamed: IC2.31 (SIM_CLK), R44.2
unnamed: IC2.32 (SIM_RST), R43.2
unnamed: IC2.33 (SIM_DET), R47.1
unnamed: L3.1, R55.2
unnamed: Q2.3 (D), R50.2
unnamed: Q3.3 (D), R51.2
POWER_SIM: C38.1, C43.1, C45.1, C46.1, C51.1, D11.1 (K), D12.2 (A), D13.2 (A), IC2.4 (VBAT_1), IC2.5 (VBAT_2), IC2.6 (VBAT_3), J10.2; also elsewhere on the board
SIM800_RST: Q1.1 (G), R40.2; also elsewhere on the board
U3RXSIM800: R46.2; also elsewhere on the board
U3TXSIM800: R41.2; also elsewhere on the board
USB_DM: IC2.27 (USB_DN)
USB_DP: IC2.26 (USB_DP)
USB_VBUS: IC2.25 (VCHG)

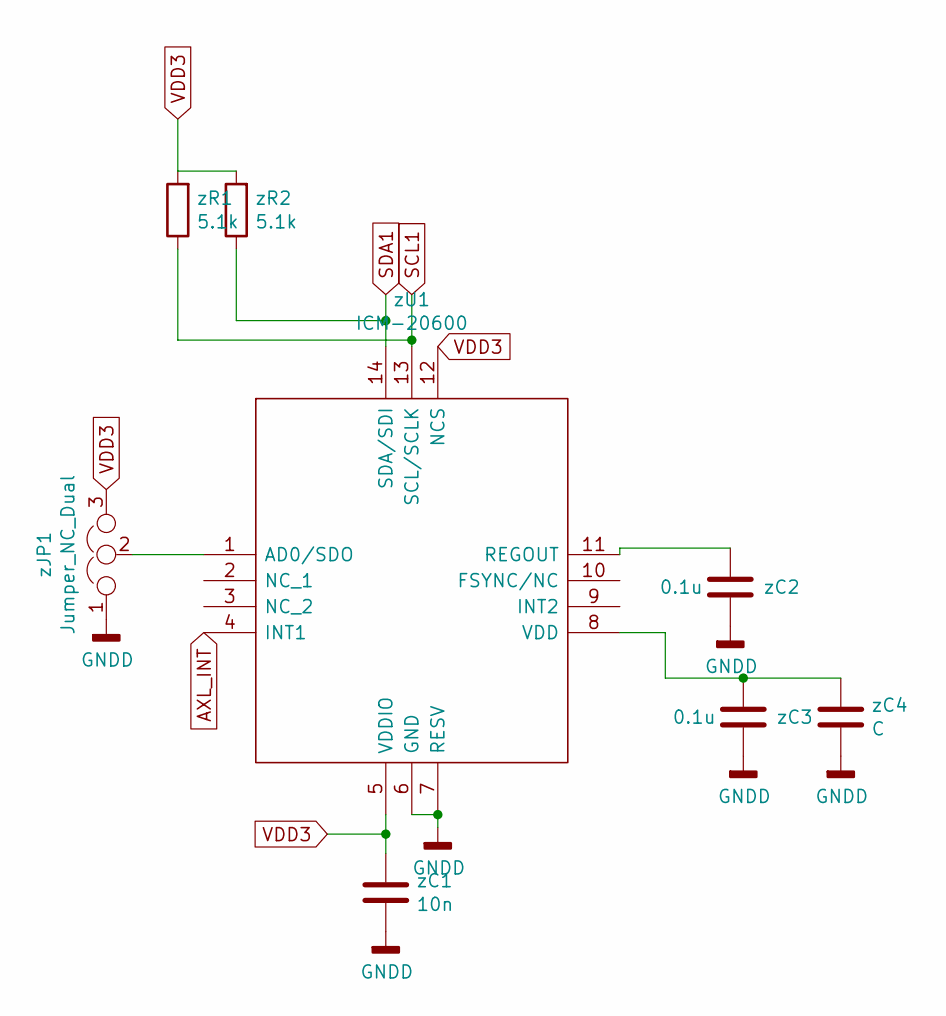
[picture p12: schematic temperature_sensor.sch]

Parts:
zC1: 10n; C_0603_1608Metric; MPN 0603B103K500NT; LCSC C57112
zC2, zC3: 0.1u; C_0603_1608Metric; MPN CC0603KRX7R9BB104; LCSC C14663
zC4: C; C_0805_2012Metric; MPN 0805F225M500NT; LCSC C49217
zJP1: Jumper_NC_Dual; SolderJumper-3_P1.3mm_Open_Pad1.0x1.5mm; LCSC N/A
zR1, zR2: 5.1k; R_0603_1608Metric; MPN 0603WAF5101T5E; LCSC C23186
zU1: ICM-20600; ICM20600; Manufacturer_Part_Number ICM-20600; Mouser Part Number 410-ICM-20600

Connections:
AXL_INT: zU1.4 (INT1)
GND: zC1.2, zC2.2, zC3.2, zC4.2, zJP1.1, zU1.6 (GND), zU1.7 (RESV); also elsewhere on the board
unnamed: zC2.1, zU1.11 (REGOUT)
unnamed: zC3.1, zC4.1, zU1.8 (VDD)
unnamed: zJP1.2, zU1.1 (AD0/SDO)
SCL1: zR1.1, zU1.13 (SCL/SCLK); also elsewhere on the board
SDA1: zR2.1, zU1.14 (SDA/SDI); also elsewhere on the board
VDD3: zC1.1, zJP1.3, zR1.2, zR2.2, zU1.5 (VDDIO), zU1.12 (NCS); also elsewhere on the board

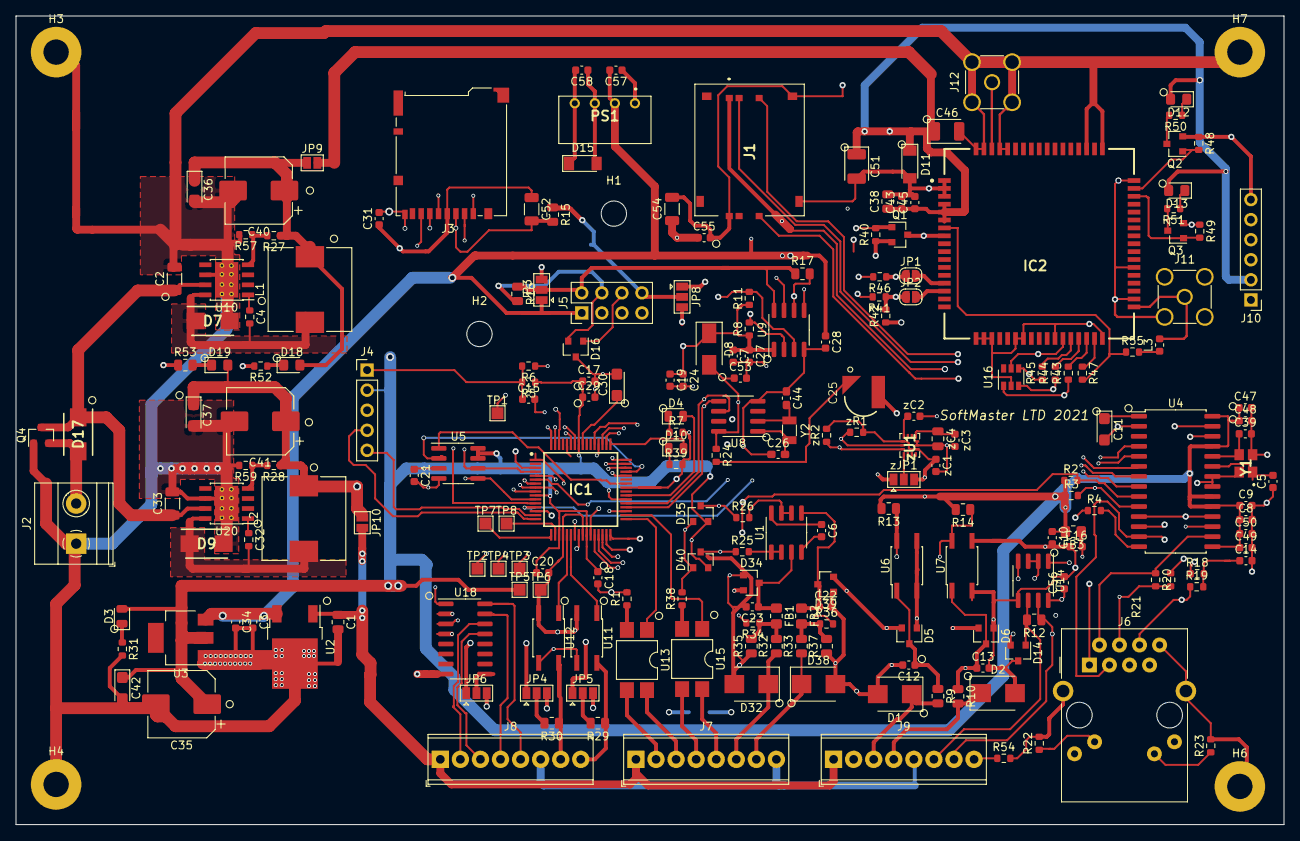
[picture p13: board saxli.kicad_pcb from above]

Board: 4 copper layers, 160.5 x 102.4 mm, 217 parts (1 on the bottom side), 153 nets.
