softmasterge/hardware_a1/(commit log)

2021-02-10 sim800 changed to sim808
    [MCU.sch, analog_in.sch, communication.sch, digital_input.sch, digital_out.sch, ethernet.sch, power.sch, saxli.sch]
2021-02-10 simcard colder changed to 78800-0001
    [communication.sch, ethernet.sch, power.sch, saxli.kicad_pcb, sim868.sch]
2021-02-11 All routed PGEC1 grounded according to errata
    [MCU.sch, sim868.sch]
2021-02-11 connector rotated.
    added rs485 output.
    TODO: add bluetooth port.
    check all parts
    preaper bom list
    prepare mouser list
    [MCU.sch, communication.sch, saxli.kicad_pcb, saxli.sch]
2021-02-12 GPS connector moved,
    antenna matching networks removed
    SUPERCAPACITOR from jlpcb used.
    [MCU.sch, communication.sch, digital_input.sch, digital_out.sch, saxli.kicad_pcb, saxli.sch, sim868.sch]
2021-02-12 minor updates
    [saxli.kicad_pcb]
2021-02-15 BOM updated
    Layout changed
    [MCU.sch, analog_in.sch, communication.sch, digital_input.sch, digital_out.sch, ethernet.sch, power.sch, saxli.kicad_pcb]
2021-02-16 Battery Footprint changed.
    Few mods
    [MCU.sch, XH414HG-IV01E.step, saxli.kicad_pcb]
2021-02-16 ENC28j60 package changed to soic 28 17.9
    TODO: route
    [MCU.sch, analog_in.sch, communication.sch, digital_out.sch, ethernet.sch, power.sch, saxli.sch, sim868.sch]
2021-02-16 ENC28j60 routed
    [saxli.kicad_pcb]
2021-02-16 ENC28j60 rerouted
    [saxli.kicad_pcb]
2021-02-17 SPI change:
    ENC28j60 on one spi
    SDCARD and EEPROM on the other.
    [MCU.sch, ethernet.sch, saxli.kicad_pcb]
2021-02-17 Ethernet connector connection fix
    [ethernet.sch, saxli.kicad_pcb]
2021-02-17 sdcard and clock capacitor added.
    [MCU.sch, ethernet.sch, power.sch, saxli.kicad_pcb]
2021-02-17 3.3V changed to basic part.
    thermal vias added for 5V regulator
    [MCU.sch, saxli.kicad_pcb]
2021-02-17 capacitor added to sd card
    [saxli.kicad_pcb, sim868.sch]
2021-02-17 power supply ldo changes
    [saxli.kicad_pcb]
2021-02-18 Isolated DCDC added
    power LED added
    reverse voltage protection added
    [communication.sch, power.sch, saxli.kicad_pcb, sim868.sch]
2021-02-18 fabrication output prepared
    [MCU.sch, communication.sch, part list.csv, pick and place.csv, power.sch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]
2021-02-18 working on JLCPCB orientations
    [analog_in.sch, part list.csv, pick and place.csv, power.sch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]
2021-02-19 JLCPCB orientation fixed
    [pick and place.csv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]
2021-02-23 oscillator footprint and capacitors changed
    [ethernet.sch, power.sch, saxli.kicad_pcb]
2021-02-24 JLCPCB crystal capacitor part number change
    [part list.csv]
2021-02-25 iso voltage update
    minor changes
    [communication.sch, digital_input.sch, digital_out.sch, part list.csv, pick and place.csv, power.sch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]
2021-02-25 25 MHZ crystal part added.
    [ethernet.sch]
2021-02-25 lm358 pn change in the output file
    [part list.csv]
2021-02-26 accelerometer added
    [MCU.sch, analog_in.sch, communication.sch, digital_input.sch, digital_out.sch, ethernet.sch, part list.csv, pick and place.csv]
2021-03-10 ULN2003 footprint updated
    [digital_out.sch, part list.csv, power.sch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]
